nam37/MicroCluck/cad/step/braced-home.step

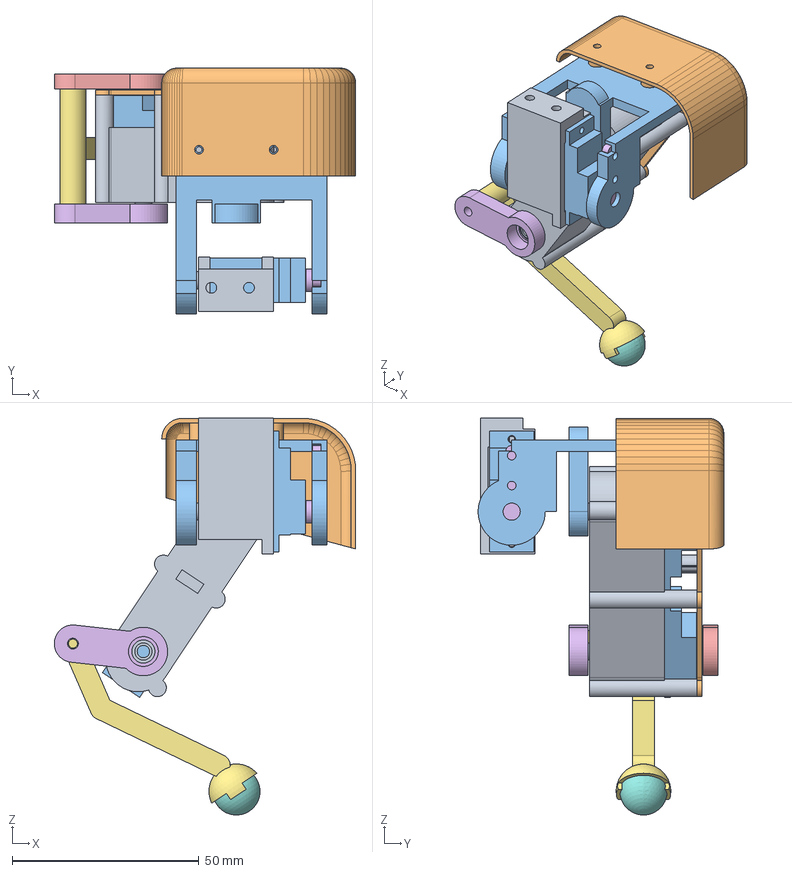
[picture p2: CAD file, 2026-11-11]
cad/step/braced-home.step
80.8 x 65.8 x 106.4 mm
