nam37/MicroCluck/cad/stl/body/body.stl

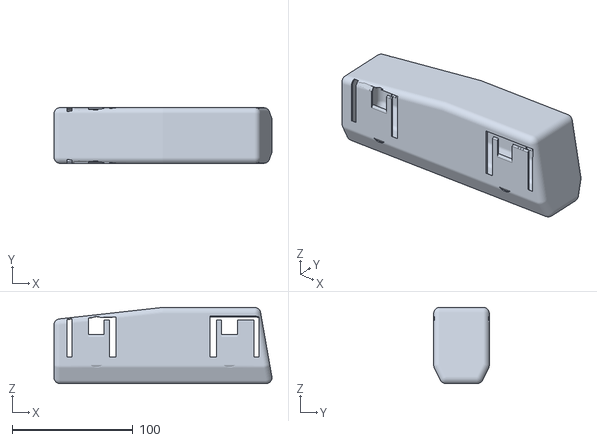
[picture p3: CAD file, 2026-11-11]
cad/stl/body/body.stl
180.2 x 46.0 x 63.0
