nam37/MicroCluck/cad/stl/braced/shank-body.stl

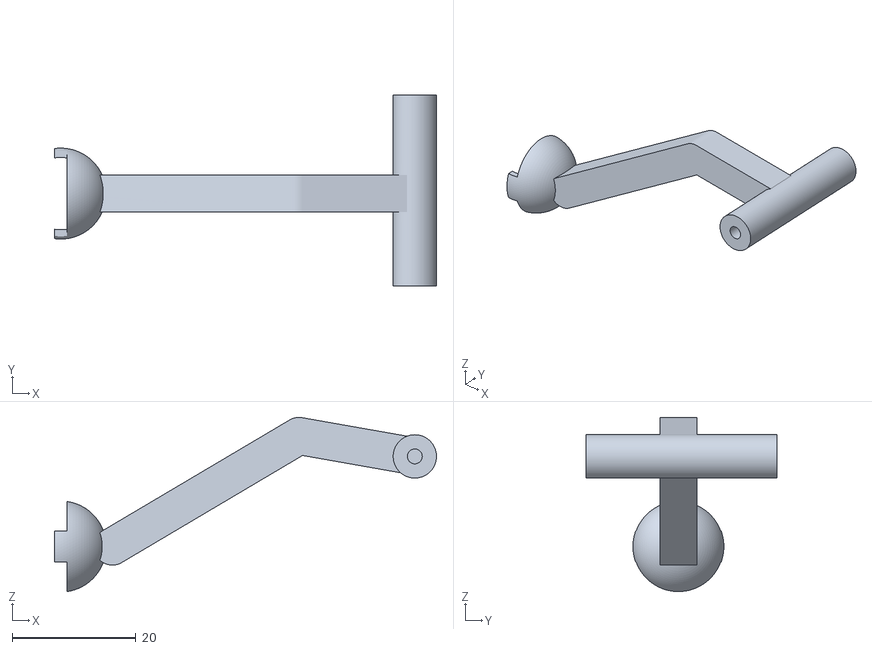
[picture p4: CAD file, 2026-11-11]
cad/stl/braced/shank-body.stl
61.7 x 30.9 x 28.1
