nam37/MicroCluck/cad/stl/leg-fit/fit-horn.stl

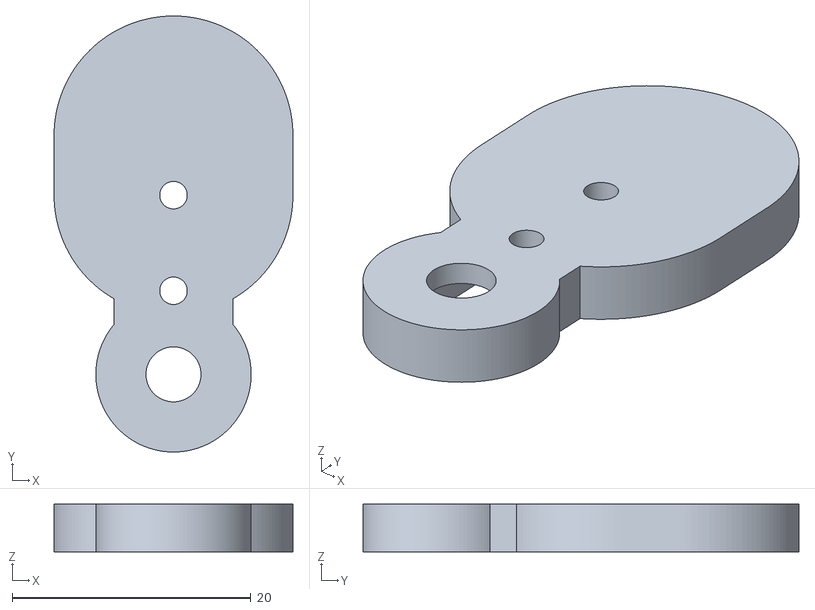
[picture p5: CAD file, 2026-11-11]
cad/stl/leg-fit/fit-horn.stl
20.0 x 36.5 x 4.00
