nam37/MicroCluck/cad/stl/leg/cover.stl

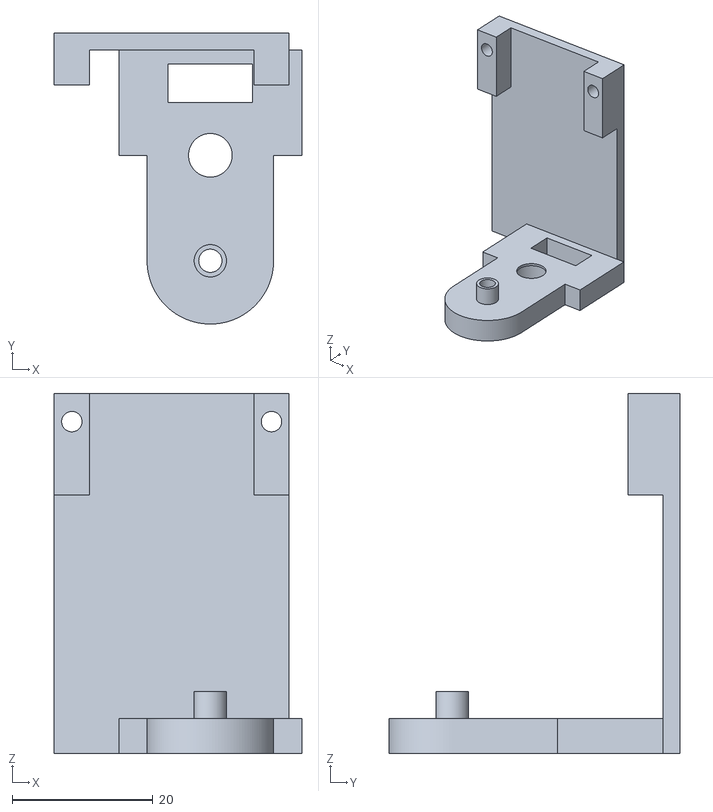
[picture p6: CAD file, 2026-11-11]
cad/stl/leg/cover.stl
35.2 x 41.4 x 51.2
