nam37/MicroCluck/cad/step/body.step

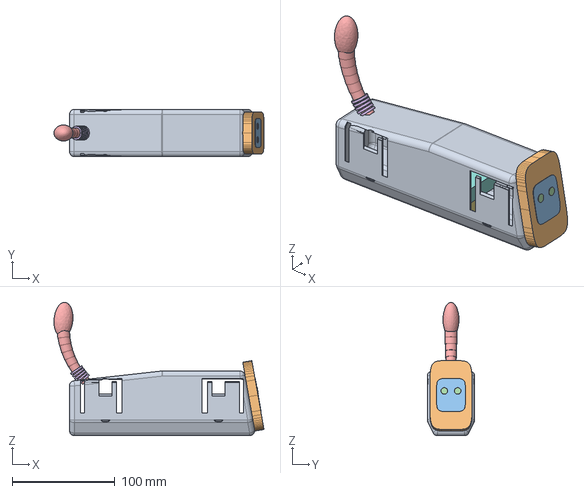
[picture p7: CAD file, 2026-11-11]
cad/step/body.step
204.3 x 46.0 x 129.8 mm
