nam37/MicroCluck/cad/stl/body/screen.stl

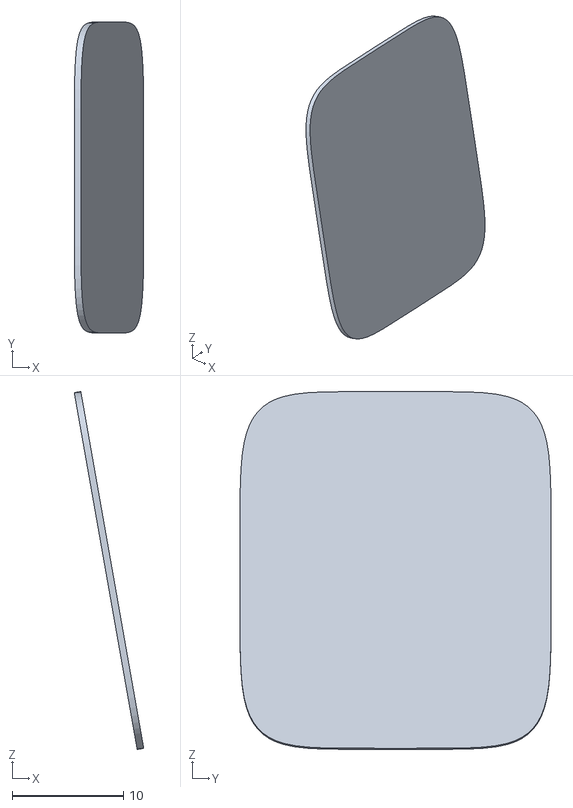
[picture p8: CAD file, 2026-11-11]
cad/stl/body/screen.stl
6.25 x 28.0 x 32.2
