nam37/MicroCluck/cad/stl/braced/bracket.stl

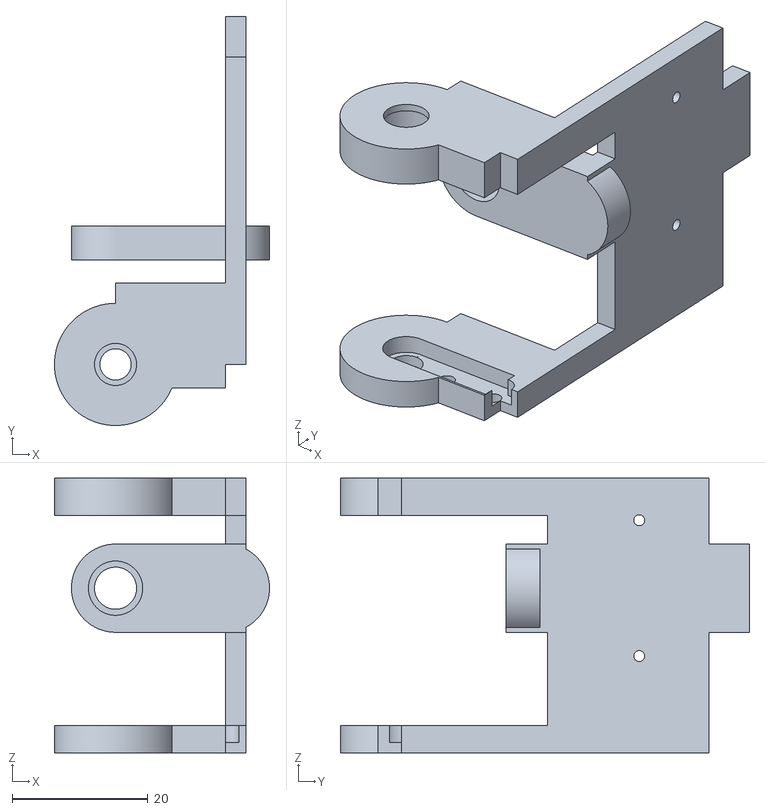
[picture p9: CAD file, 2026-11-11]
cad/stl/braced/bracket.stl
31.7 x 60.2 x 40.5
