nam37/MicroCluck/cad/stl/leg-fit/fit-cradle.stl

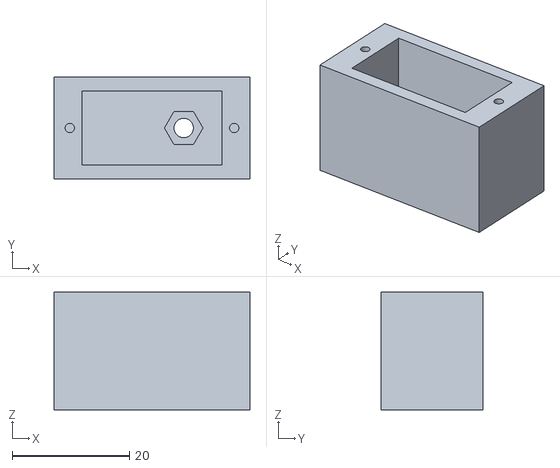
[picture p10: CAD file, 2026-11-11]
cad/stl/leg-fit/fit-cradle.stl
33.4 x 17.4 x 20.1
