nam37/MicroCluck/cad/stl/leg/long-link.stl

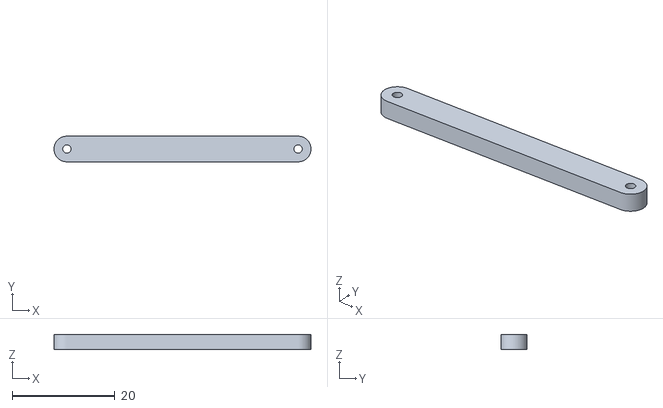
[picture p11: CAD file, 2026-11-11]
cad/stl/leg/long-link.stl
50.0 x 5.00 x 3.00
