nam37/MicroCluck/cad/step/leg-home.step

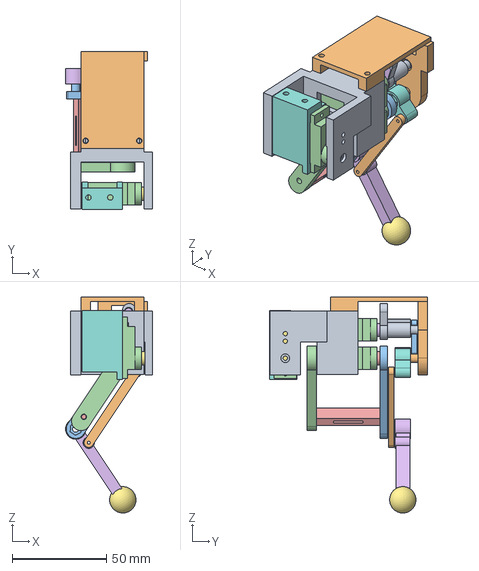
[picture p12: CAD file, 2026-11-11]
cad/step/leg-home.step
46.0 x 83.5 x 114.3 mm
