nam37/MicroCluck/cad/stl/body/eyes.stl

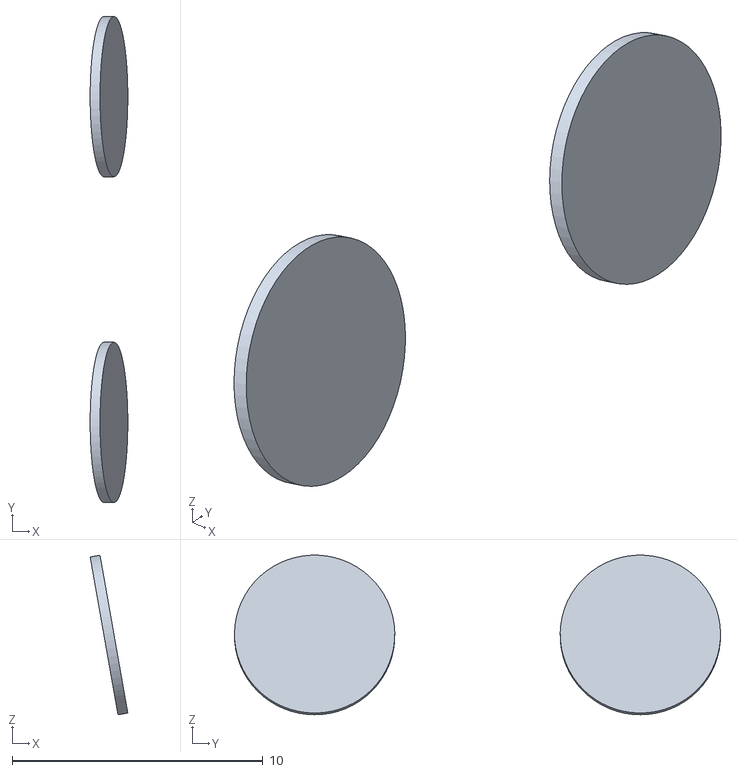
[picture p13: CAD file, 2026-11-11]
cad/stl/body/eyes.stl
1.50 x 19.4 x 6.37
