nam37/MicroCluck/cad/stl/braced/outer-arm.stl

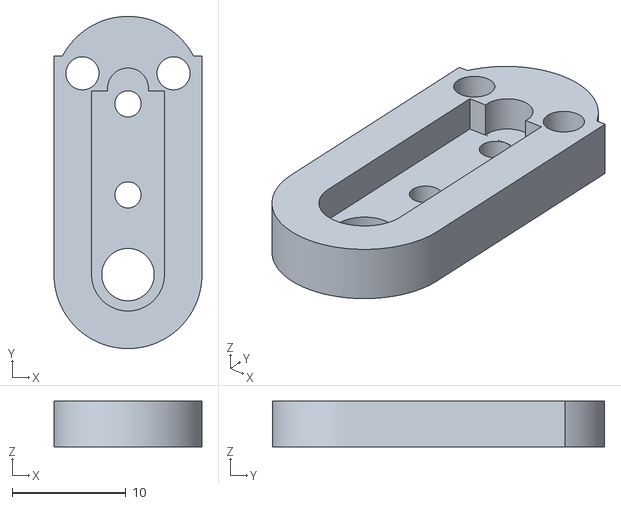
[picture p14: CAD file, 2026-11-11]
cad/stl/braced/outer-arm.stl
13.0 x 29.2 x 4.00
