nam37/MicroCluck/cad/stl/leg-fit/fit-bearings.stl

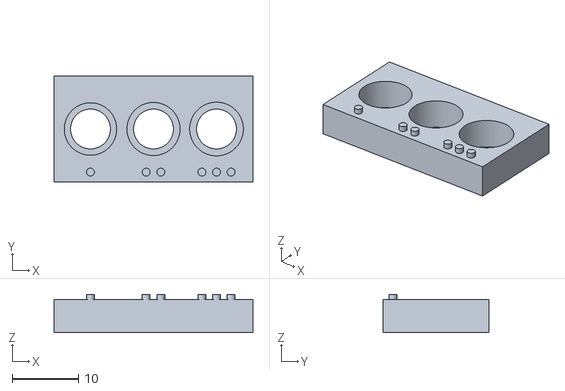
[picture p15: CAD file, 2026-11-11]
cad/stl/leg-fit/fit-bearings.stl
30.0 x 16.0 x 5.80
