nam37/MicroCluck/cad/stl/leg/outer-plate.stl

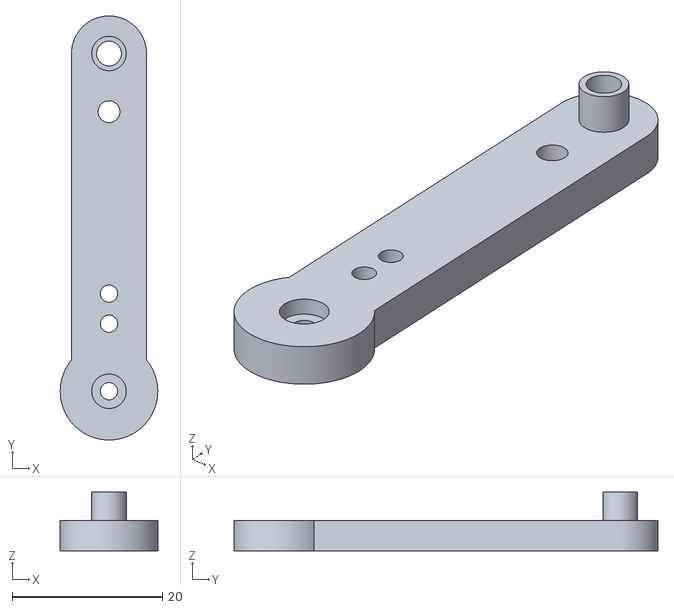
[picture p16: CAD file, 2026-11-11]
cad/stl/leg/outer-plate.stl
13.0 x 56.5 x 7.80
