nam37/MicroCluck/cad/stl/body/bezel.stl

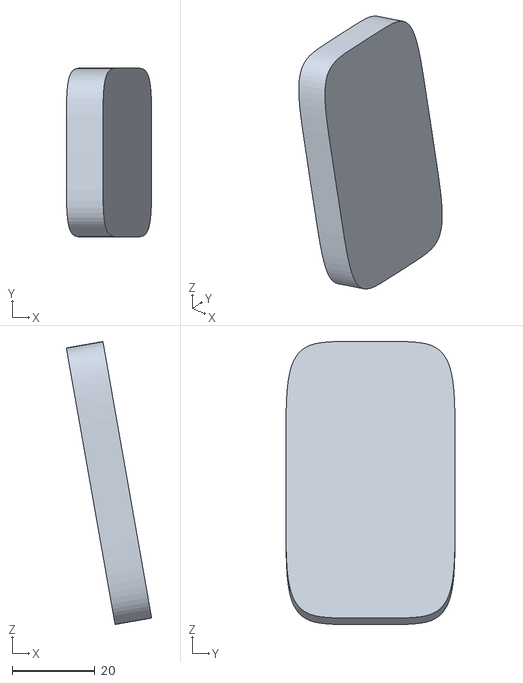
[picture p17: CAD file, 2026-11-11]
cad/stl/body/bezel.stl
20.7 x 41.0 x 68.5
