nam37/MicroCluck/cad/stl/braced/shell.stl

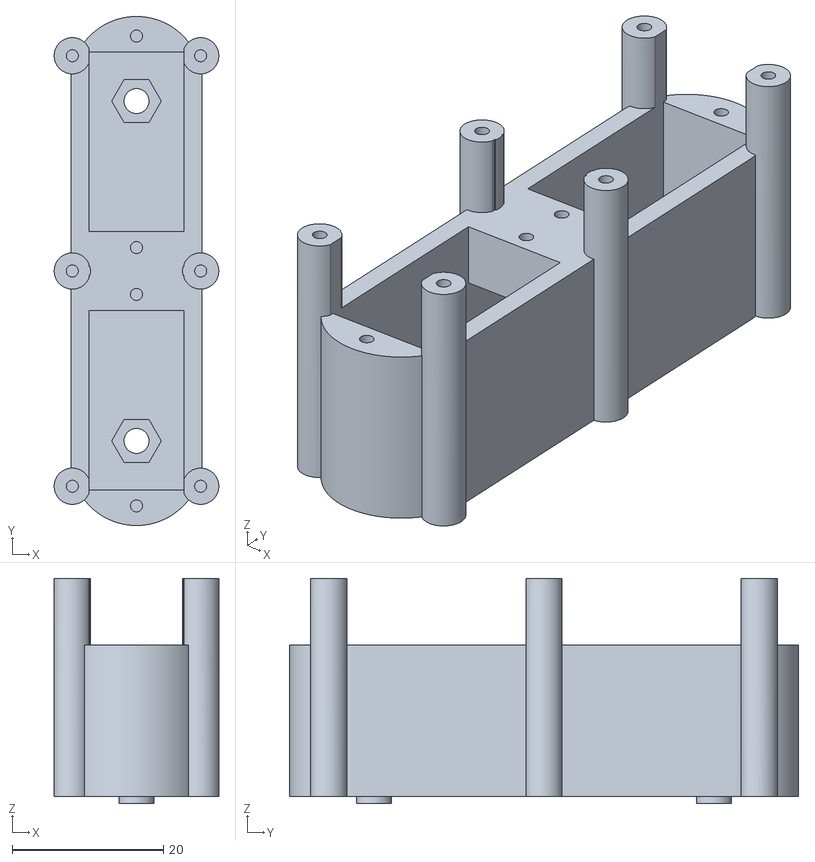
[picture p18: CAD file, 2026-11-11]
cad/stl/braced/shell.stl
21.8 x 67.4 x 29.8
