nam37/MicroCluck/cad/stl/leg-fit/fit-pilots.stl

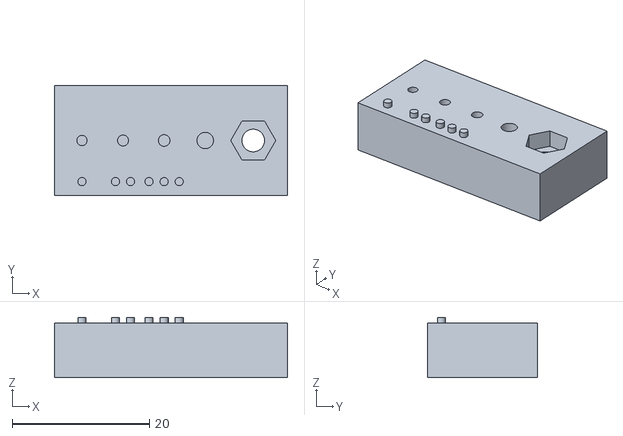
[picture p19: CAD file, 2026-11-11]
cad/stl/leg-fit/fit-pilots.stl
34.0 x 16.0 x 8.80
