nam37/MicroCluck/cad/stl/leg/abd-mount.stl

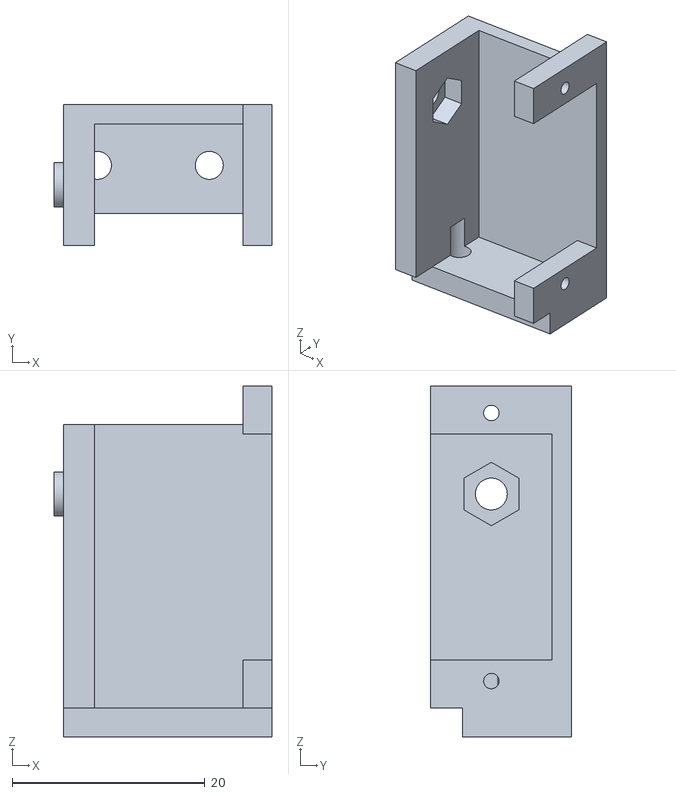
[picture p20: CAD file, 2026-11-11]
cad/stl/leg/abd-mount.stl
22.6 x 14.6 x 36.4
