nam37/MicroCluck/cad/stl/body/tail_boot.stl

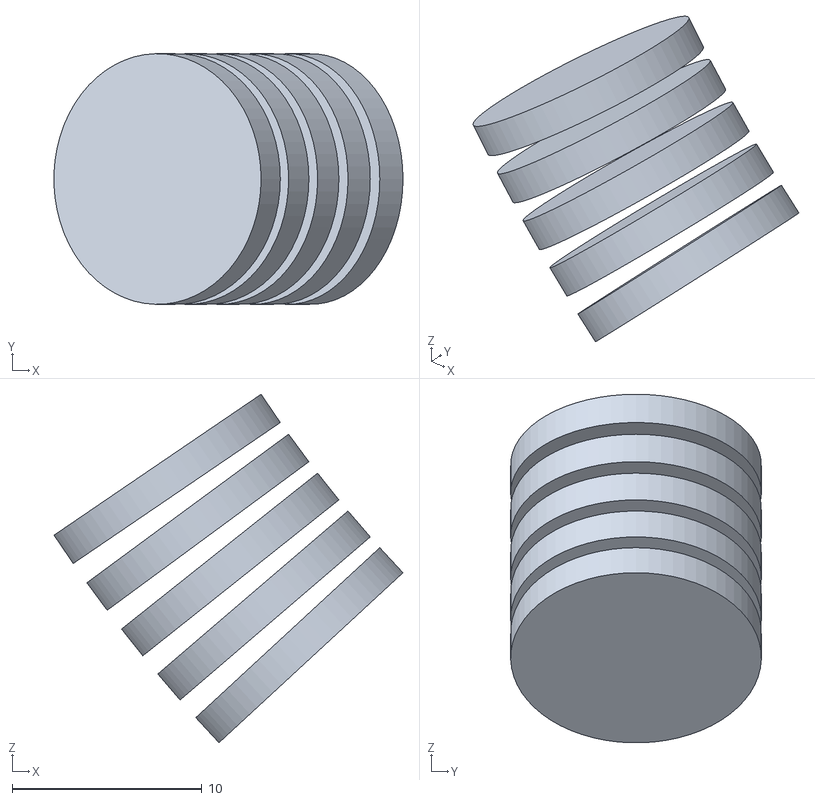
[picture p21: CAD file, 2026-11-11]
cad/stl/body/tail_boot.stl
18.4 x 13.2 x 18.4
