nam37/MicroCluck/cad/stl/braced/rigidity-plate.stl

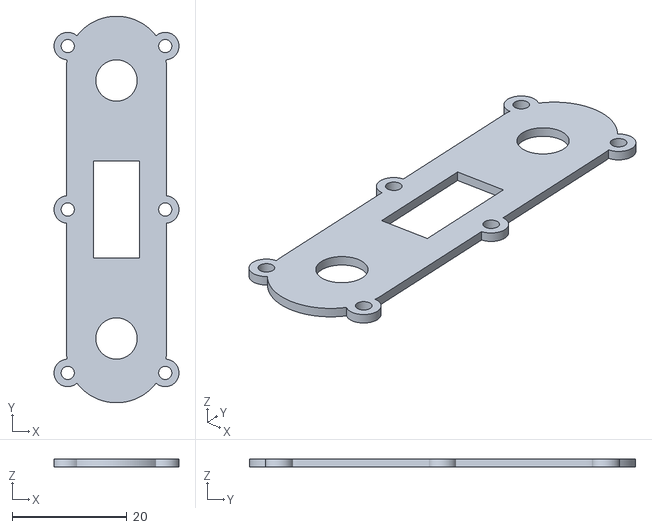
[picture p22: CAD file, 2026-11-11]
cad/stl/braced/rigidity-plate.stl
21.8 x 67.4 x 1.35
