nam37/MicroCluck/cad/stl/leg/knee-crank.stl

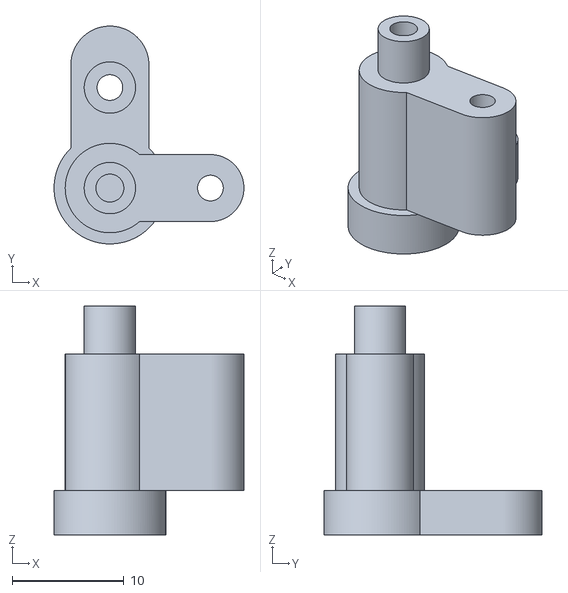
[picture p23: CAD file, 2026-11-11]
cad/stl/leg/knee-crank.stl
17.0 x 19.5 x 20.5
