nam37/MicroCluck/cad/stl/body/tail.stl

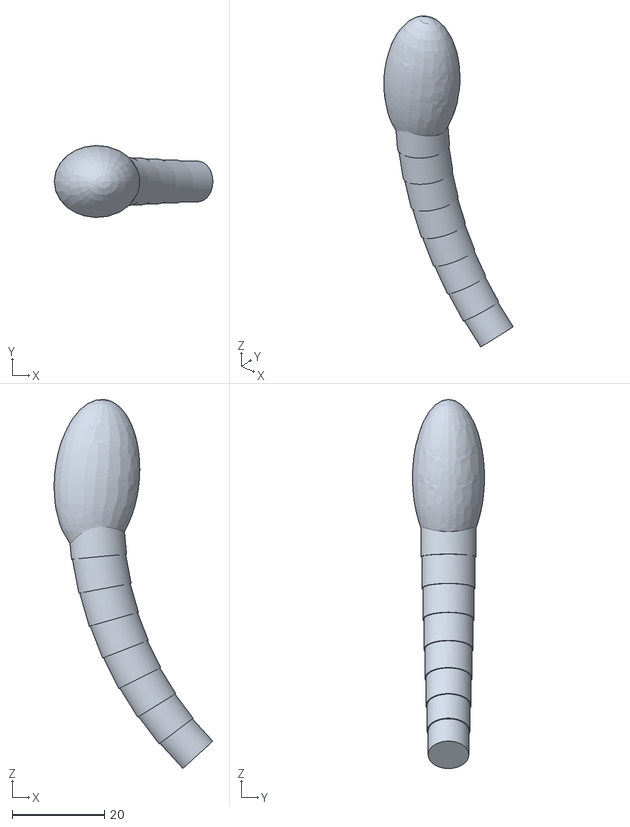
[picture p24: CAD file, 2026-11-11]
cad/stl/body/tail.stl
34.4 x 15.6 x 80.0
