nam37/MicroCluck/cad/stl/braced/shoulder-cover.stl

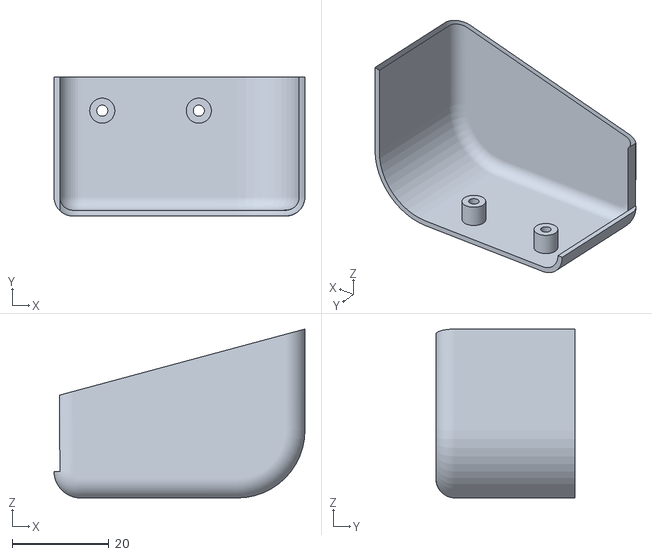
[picture p25: CAD file, 2026-11-11]
cad/stl/braced/shoulder-cover.stl
52.0 x 28.9 x 35.0
