nam37/MicroCluck/cad/stl/leg/inner-plate.stl

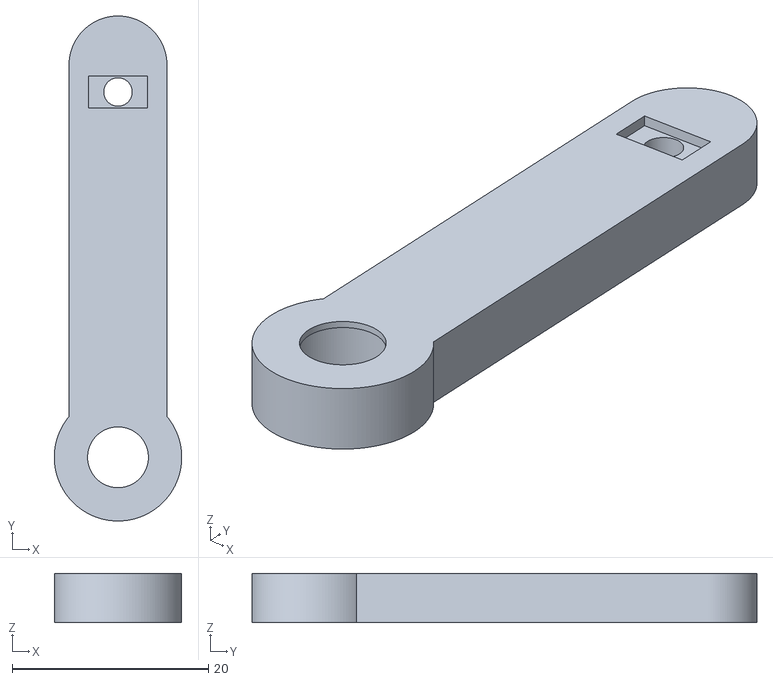
[picture p26: CAD file, 2026-11-11]
cad/stl/leg/inner-plate.stl
13.0 x 51.5 x 5.00
