nam37/MicroCluck/cad/stl/braced/shank-outer.stl

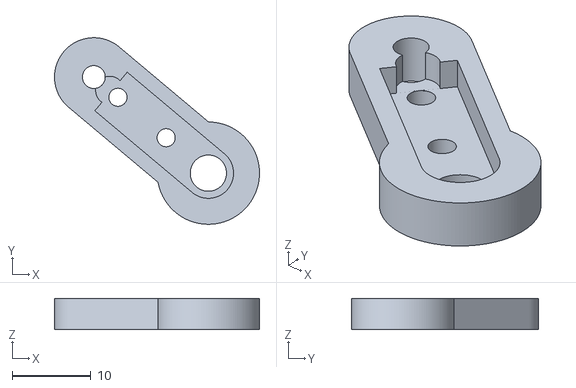
[picture p27: CAD file, 2026-11-11]
cad/stl/braced/shank-outer.stl
26.1 x 23.7 x 4.00
