nam37/MicroCluck/cad/stl/leg/foot.stl

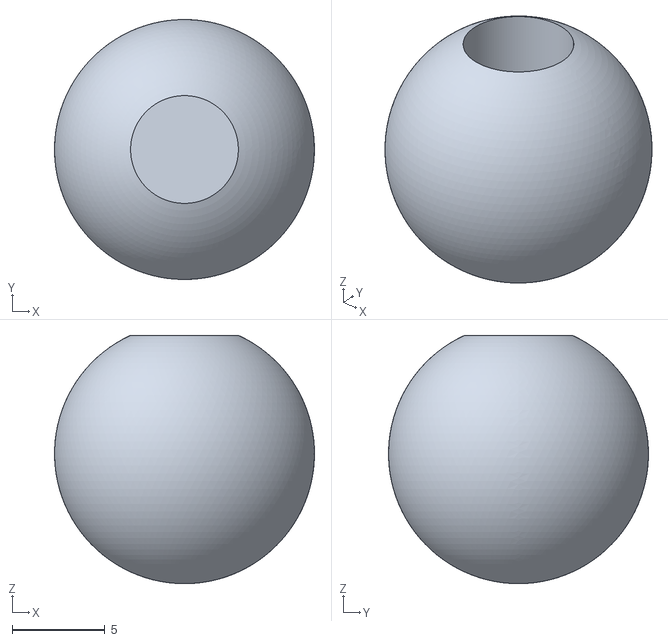
[picture p28: CAD file, 2026-11-11]
cad/stl/leg/foot.stl
14.0 x 14.0 x 13.4
