nam37/MicroCluck/cad/stl/braced/abd-mount.stl

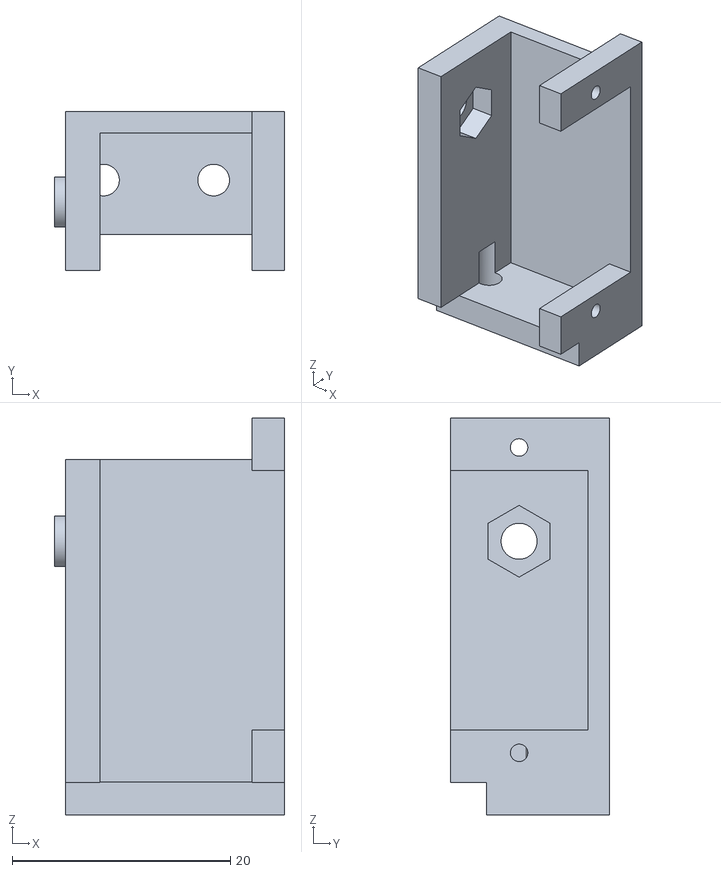
[picture p29: CAD file, 2026-11-11]
cad/stl/braced/abd-mount.stl
21.1 x 14.6 x 36.4
