nam37/MicroCluck/cad/stl/leg/holder.stl

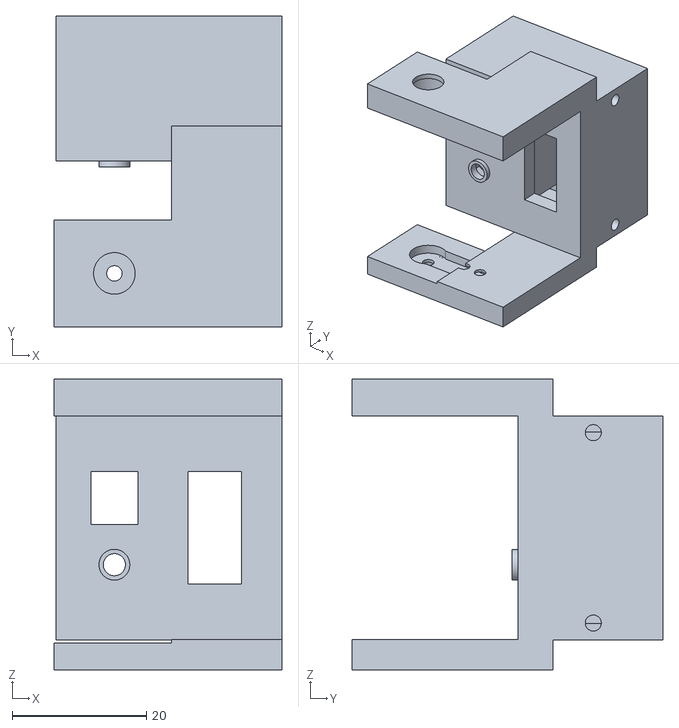
[picture p30: CAD file, 2026-11-11]
cad/stl/leg/holder.stl
34.0 x 46.4 x 43.4
