nam37/MicroCluck/cad/stl/braced/shank-inner.stl

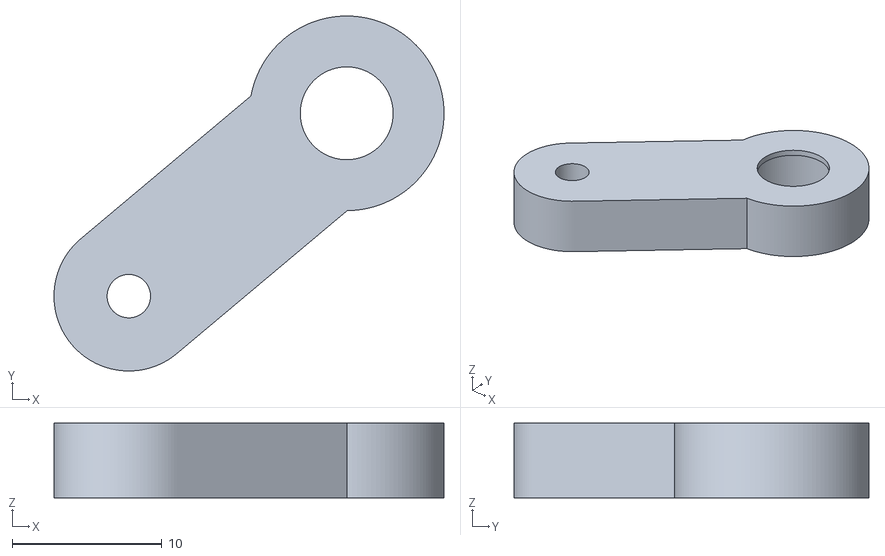
[picture p31: CAD file, 2026-11-11]
cad/stl/braced/shank-inner.stl
26.1 x 23.7 x 5.00
