nam37/MicroCluck/cad/stl/leg/short-link.stl

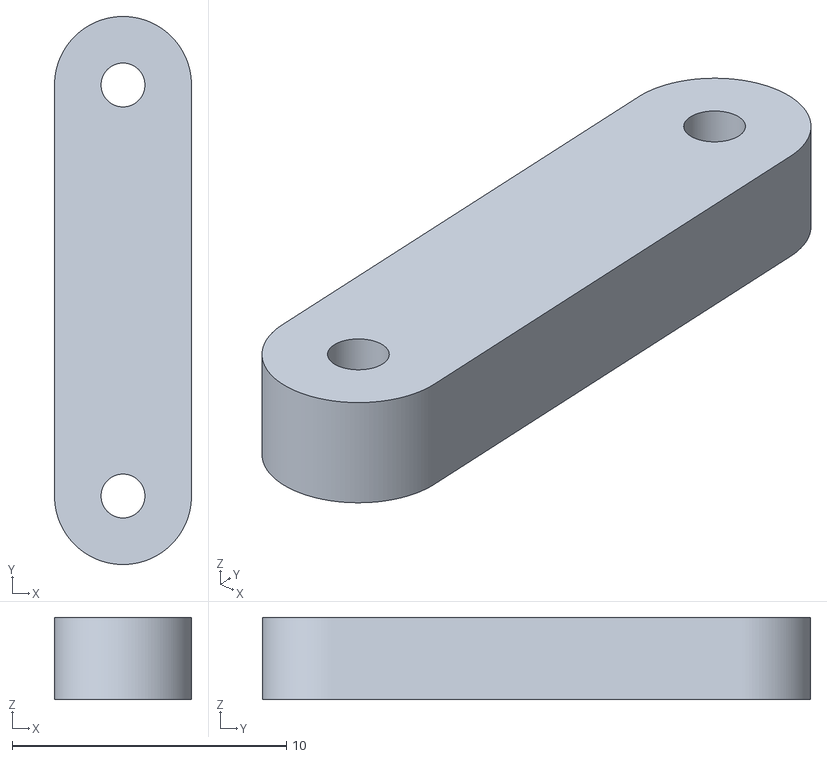
[picture p32: CAD file, 2026-11-11]
cad/stl/leg/short-link.stl
5.00 x 20.0 x 3.00
