nam37/MicroCluck/cad/stl/leg/shank.stl

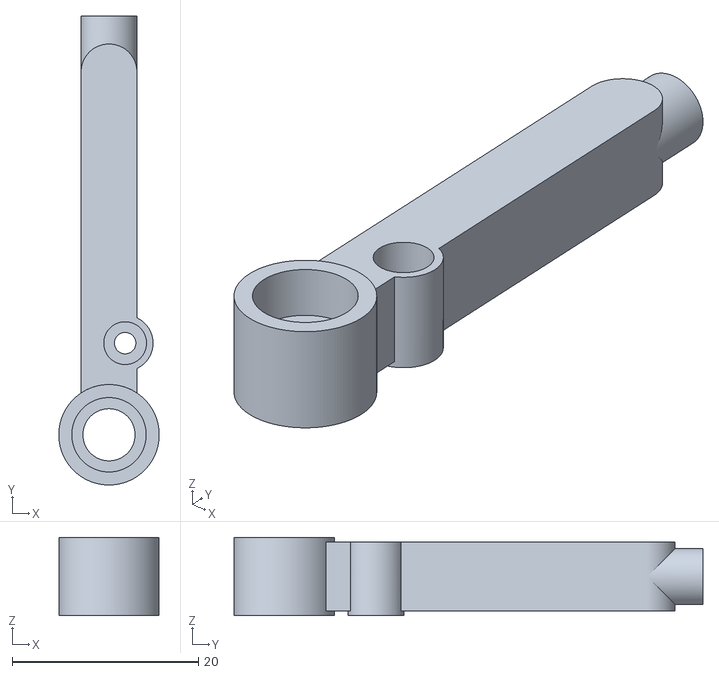
[picture p33: CAD file, 2026-11-11]
cad/stl/leg/shank.stl
10.8 x 50.4 x 8.40
