nam37/MicroCluck/cad/stl/leg/bellcrank.stl

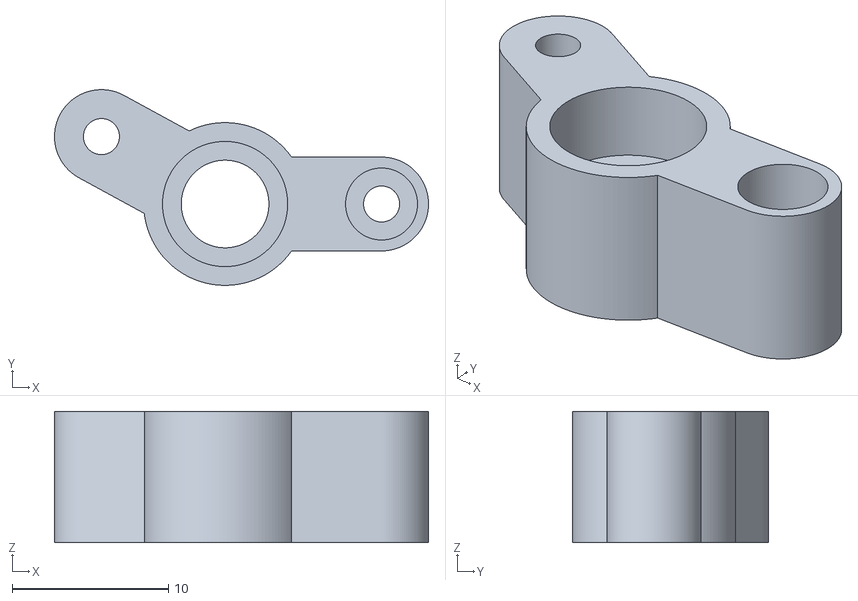
[picture p34: CAD file, 2026-11-11]
cad/stl/leg/bellcrank.stl
23.9 x 12.5 x 8.40
