nam37/MicroCluck/cad/stl/leg/bridge.stl

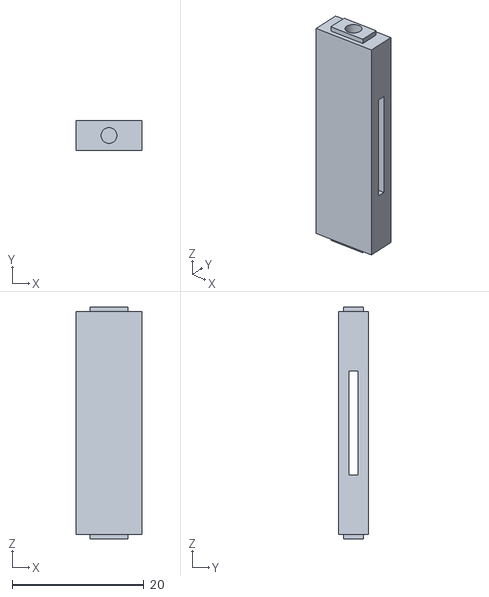
[picture p35: CAD file, 2026-11-11]
cad/stl/leg/bridge.stl
10.0 x 4.50 x 35.2
