nam37/MicroCluck/(commit log)

2026-10-27 Add MicroCluck product requirements document (draft v0.5)
    docs/PRD.html is the current PRD. The superseded v0.3 Markdown draft is
    kept under docs/archive.
2026-10-27 Run servos from the 2S pack and zero-pad command slots (PRD v0.7)
    Servo power follows Microduck and its training model: the pack feeds the
    servos directly (6.6-8.4 V), so the 5 V servo buck is removed. Shutdown is
    set to 52 and health checks ignore the Input Voltage Error bit. The S3
    peak-torque check uses the ~0.60 N.m current-limit ceiling.
    The observation keeps Pollen's 13-slot command block zero-padded (49
    inputs), and the simulation model is edited by hand because Pollen's CAD
    is not published. Adds Pollen's known runtime values to the sim2real
    contract and two watchlist rows (servo supply voltage, no head).
2026-10-27 Add the parametric foot toes in hardware/ and PRD v0.9
    OpenSCAD is the CAD tool for the parametric parts. hardware/ holds one parameter table (params.scad)
    that drives both the printed toes and the simulation: three chunky toes fused onto the front wall of
    Pollen's sole, plus the convex-hull collision shape the sim uses. Pollen's STL files are not copied
    here (CC BY-NC-SA 4.0); the build points at a local copy. Generated STLs are git-ignored.
    PRD v0.8 and v0.9: corrections found while building the first MicroCluck model (tiny command-slot
    ranges, the stock 512-256-128 actor, action scale 1.0 in training and 0.9 on the robot, the head chain
    being 38% of the stock duck's mass), the OpenSCAD d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
    [collision_with_toes.scad, params.scad, pollen_frame.scad, sole_with_toes.scad, toes.scad, toes_lib.scad]
2026-10-27 PRD v0.10: re-base the S3 torque checks on the stock duck's S0 baseline
    The S0 torque baseline (stock walker at iteration 2,000, BAM actuator model, random velocity commands)
    shows Pollen's own duck exceeds the datasheet's ~0.10 N.m continuous rating on hip pitch (0.145 N.m RMS)
    and knee (0.16-0.17) and reaches the 0.64 N.m actuator ceiling on every joint. The S3 thermal and
    peak-torque pass conditions are now relative to the stock duck, with the baseline numbers recorded.
2026-10-28 PRD v0.11: add the parametric body shell in hardware/
    A hollow shell joins the screen bezel's back face to the tail and holds the battery and electronics,
    with a tail socket, a USB-C slot, a power-switch hole and vents. It is a parametric OpenSCAD part:
    torso.scad holds the part layout and shell parameters (geometry only, masses live in the sim) and
    shell.scad builds the body. tools/build_shell.sh exports the STLs and the simulation copies, and
    tools/shell_report.py prints size, wall volume and an estimated mass.
    The simulation draws the battery, electronics and shell (visual-only, physics unchanged) and checks
    that the contents fit and that the legs clear the shell over recorded gait poses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
    [shell.scad, torso.scad]
2026-10-28 PRD v0.12: record the pushes in the S0 baseline and the first MicroCluck results
    The S0 torque baseline and fall counts were measured under the play
    configuration's pushes (every 0.5-1 s), which v0.10 did not say. Add the
    no-push fall result, MicroCluck's torque and fall comparison against the
    stock duck, the walking-speed table (both robots reach about half the
    commanded speed), and the shell clearance with MicroCluck's own gait
    (7.5 mm over all 96,000 poses). Two new watchlist rows cover walking speed
    and the pushed baseline. hardware/README.md gets the clearance result.
2026-10-28 PRD v0.13: egg-shaped shell with wings, and the target look
    Shell (hardware/): torso.scad and shell.scad gain an egg style next to the box. The egg stacks
    convex slices between the bezel cap and a rear wall, with a rounded rear edge (egg_edge_r) and a
    cavity inset that follows the local slope. shell_rear_x sets the depth: the default, -64 mm,
    makes the body 86 mm deep and encloses the placeholder tail block; -30 gives the 52 mm shells.
    Two flat wing discs lie on the sides as a separate part (wings.stl). build_shell.sh also exports
    the cavity and the wings, picks the style, and takes name=value overrides of any torso.scad
    parameter. shell_report.py reports the wings. The README compares the b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
    [shell.scad, torso.scad]
2026-10-28 PRD v0.14: target-look shell, 70 mm deep with the tail behind the rear wall
    Shell (hardware/): the default egg is now the target-look shape: 70 mm deep (shell_rear_x = -48),
    top sloping about 20 degrees from the bezel, rounded rear edge, and an underside that rises 18 mm
    toward the rear (egg_power_floor, shell_rear_z0 = 42). The tail placeholder moves behind the rear
    wall (tail_pos x = -63), and the rear wall gets an opening for the tail's mounting stub
    (tail_stub_size, tail_stub_z) instead of one sized from the tail block. The USB slot is a column
    through the rising floor. The cavity wall pad now grows from the front to the rear
    (egg_wall_pad, egg_wall_pad_rear) so the front walls stay ligh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
    [shell.scad, torso.scad]
2026-10-30 PRD v0.15: getting up from the screen, and where the hips go
    New section 7.5 with the stand-up and walking results from simulation:
    - the stock leg layout cannot get up from lying face down (0 of 64);
    - with the leg mounts raised 55 mm or more it can (60 to 64 of 64), tested
    with the legs 25 mm outside the shell;
    - walking with the hips raised 70 mm stands still from a cold start but
    walks when warm-started from the stock policy, with weaker push recovery;
    - what is not shown yet: one layout that gets up, walks and fits the screen,
    battery and electronics.
    Also a risk row, a watchlist row, an open question on the hip position, and a
    note on the H7 milestone.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
2026-10-30 PRD v0.15: say that the stand-up runs let only the soles and torso collide
    The simulator switches off every geom not named *_collision, so the thighs, shanks and hip brackets
    passed through the floor and body in the stand-up searches. The stock layout's failure stands; the
    successes are upper bounds and are being re-run with all leg parts colliding.
2026-10-30 PRD v0.16: stand-up re-run with every leg part colliding
    The simulator collides only geoms named for collision, so in v0.15's searches the thighs, shanks and
    hip brackets passed through the floor and the body. With every leg part colliding, legs 25 mm outside
    the shell and the stock hip position both fail (0 of 64); hips raised 70 mm, at the stock spacing and
    moved 29 mm back, get up in 62 of 64 starts. Walking at that hip position is untested and the hips sit
    inside the shell's outline, so the shell needs openings. Table, packaging, watchlist and open question
    updated.
2026-10-30 PRD v0.17: walking with the hips moved back, and getting up from the back and side
    The hips raised 70 mm and moved 29 mm back (the one layout that gets up face-down with every leg part
    colliding) also walks: the home pose leans 43° at the hip pitch, and the stock policy trained 500 more
    iterations reaches 0.17 and 0.24 m/s at 0.3 and 0.4 m/s commands (stock hips 0.19 and 0.27), with 30
    falls against 27 under pushes. Lying flat on the back neither layout gets up (0 of 64); from starts
    rolled toward the side the hips-back layout gets up in 6 of 64. Packaging, gait clearance and a
    sit-up-then-stand recovery are still open.
2026-10-30 PRD v0.18: corrected raised-hip results, feather-fan tail, mean-motion replays
    Pollen's chassis plate and its 50 g were left at the old low position in every raised-hip test since
    v0.15, putting the whole-body center of mass 9 mm too low; v0.17's hips-back numbers are superseded.
    With the chassis moved, the tail estimated from the design mockups as a rigid feather fan, and every leg
    part colliding: hips raised 70 mm and 29 mm back get up face-down in 255 of 256 starts (61 to 84% with
    the earlier tail block), walk at 91-93% of the stock layout's speed (home pose leaning 41 degrees, 31
    falls under pushes against 19), get up from flat on the back in 3% and from the side in none; the stock
    hips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
2026-10-30 PRD v0.19: getting up from the back and side by rolling onto the front first
    The back and side searches of v0.17/v0.18 kept the legs mirrored, which cannot roll the body, so
    their 3% and 0% described mirrored motions only; the text now says so. With all ten joints free,
    rolling onto the front works (256/256 from flat on the back and from a side, mean motions), and a
    stand-up searched behind it gets up 255/256 from up to 30 deg from flat on the back and 254/256
    from a side. Around 45 deg neither roll is reliable. A recovery policy trained from scratch on
    lying starts learned nothing (0/256, action noise 1.0 -> 0.12). All open-loop, in simulation.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
2026-10-31 PRD v0.20: how far the open-loop get-up holds under changed physics
    The two chained recoveries (from a side, and from up to 30 degrees off flat on the back) replayed on 256 starts
    with friction, battery voltage, servo delay, extra trunk mass and the trunk centre of mass changed. Single changes
    cost little; extra mass with a low battery drops them to 42% and 24%; the centre of mass 10 mm back or down, or 20 mm
    anywhere, takes them to about 0%. Taking away all leg-body contact drops them to 49% and 77%. The roll onto the
    front survives the combined worst case; the stand-up behind it is what breaks. An earlier version of this test did
    nothing for the centre of mass and is corrected. hardware/RE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
2026-10-31 PRD v0.21: the get-up works inside a narrow window of the fore-aft balance point; robust re-search
    Corrects v0.20: the collapse under extra mass plus a low battery is a shift of the balance point, not a torque limit. The same
    combination with the trunk centre of mass 8 mm back gets 95-100% for all four motions and 8 mm forward gets 0%. Each motion gets up
    in 84% or more of starts only between about 4 mm back and 8 mm forward of the model's centre of mass. Searching the motions again
    over randomized physics worked only as a warm start from the existing stand-ups (from scratch the stand-up never reached
    standing); the re-searched motions are better under low friction, low battery and mass plus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
2026-10-31 hardware: bezel with top and bottom bumper lips (bezel.scad), lip parameters in torso.scad
    The frame's top and bottom edges become rounded bars standing bezel_lip_proud ahead of the frame face (6 mm placeholder; 0 is the flat
    frame). The sim collides with capsules built from the same numbers; with up to 8 mm its open-loop get-up works, at 12 mm the side get-up falls to 70%.
    [bezel.scad, torso.scad]
2026-10-31 PRD v0.22: a learned correction on the get-up motions widens the balance-point window from 12 to 32+ mm; bezel bumper lips in the model
    The policy corrects the open-loop roll and stand-up: 98-100% of starts from 12 mm back to 20 mm forward of the model's centre of mass (open loop:
    4 mm back to 8 mm forward), 100% under extra mass with a low battery and under a combined worst case. Weak point: servo delay beyond the 50 ms it
    was trained on. Bezel lips up to 8 mm leave the open-loop get-up unchanged, 12 mm drops the side get-up to 71%; the policy trained with 6 mm lips
    loses backward margin on a flat bezel. Simulation only.
2026-11-09 PRD v0.23: robot-dog simulation study (docs/quadruped-study.html)
    Walking, servo load against the stock duck, belly get-up, and the rejected
    knee-at-hip and lean-mass variants, from runs 4-7 of the 8-servo quadruped.
2026-11-09 BOM: XL330-M288-T price and source, U2D2 added (PRD 6.1 and the dog study)
2026-11-10 PRD v0.24: MicroPup replaces the MicroCluck biped
    Rewritten around the dog: DeskSprite face on the FNK0104N, an 8-servo
    XL330 body with an XL330 tail, and three boards (face, body ESP32-S3 with
    all safety, XIAO ESP32S3 Sense vision). Camera moves to the forehead,
    tilted up with a wide lens; ToF stays in the chin with an obstacle stop
    (S11). Face-body UART link, lie-down/stand-up state machine, v2 autonomy
    with vision off the robot, BOM ~$505-565. The biped PRD is archived
    unchanged at docs/archive/PRD-MicroCluck-v0.23.html.
2026-11-10 PRD: the relay's 1 CPU / 256 MiB are its container limits, not the VPS's size; v2 vision gets its own container
2026-11-10 PRD: home Raspberry Pi 4 as a possible future vision server, reached over Tailscale via the VPS away from home
2026-11-10 PRD v0.25: ESP32-P4 (FireBeetle 2) is the default vision board; person detection on the robot
2026-11-10 PRD v0.26: Waveshare ESP32-P4-WIFI6 Kit A for camera bring-up (V0); robot's P4 board chosen after V0
2026-11-10 PRD v0.27: ESP32-S3 N16R8 2-pack as body-board bench boards; XIAO stays the robot default
2026-11-10 PRD v0.28: SG90-class micro servo for the tail, XL330 order 8 + 1 spare (~$247)
2026-11-10 PRD BOM: U2D2 Power Hub Board for bench servo setup
2026-11-10 PRD v0.29: the four pre-freeze simulation checks pass on the final model
    Forehead camera, chin ToF and ears in the model (596 g); run 8 trained with
    +-1 deg gear play walks 0.26 m/s at 0.3, turns 0.70 rad/s, no falls, worst
    joint 0.123 N.m; leg clearance >= 6 mm to the shell and 19 mm to the bezel
    over 96,000 gait poses; scripted lie-down 64/64 under every stress. Study
    page gains a run 8 section.
2026-11-10 Docs: servo cost study (STS3215 and MG90S rejected), PRD v0.30 build-or-buy question
2026-11-10 PRD v0.31: MicroPup redesigned for cost (MG90S, one ESP32-P4 board, 1.69in face); XL330 PRD archived as v0.30
2026-11-10 PRD v0.33: scripted trot walks the MG90S micro dog in sim (0.16 m/s, steers, no falls under pushes); MG92B under test
2026-11-10 PRD: BOM and servo drive for the scripted gait, no potentiometer read-back; MG92B noted as an option
2026-11-11 PRD v0.34: MG92B walks on a learned policy with pot read-back; 3 servos per leg gives no gain; servo choice reopened
2026-11-11 CAD: Orion-style 12-servo MG92B leg in build123d, with fit coupons and a range-of-motion checker
    Holder for the stacked hip and knee servos hung from the abduction servo (horn in front, 693 bearing behind), two-plate thigh with a bearing behind the hip servo, bellcrank and two parallelogram links to the knee, shoulder cover carrying the bellcrank axle and the knee crank's outer bearing. check_fit.py finds no collisions over knee 30-140, hip -35..+70 and abduction +-29 for front and rear legs.
    [abd-mount.stl, bellcrank.stl, bridge.stl, cover.stl, fit-bearings.stl, fit-cradle.stl, fit-horn.stl, fit-pilots.stl]
2026-11-11 CAD: whole-robot animation of the Orion-style legs (MuJoCo, kinematic): stand, trot, paw, crouch
2026-11-11 CAD: MicroDuck-braced 12-servo leg (hip and knee servos in the thigh, U hip bracket, fork shank); 46.5 mm wide vs 69, no collisions over knee 0-150, hip -70..+80, abduction +-29
    [abd-mount.stl, braced-home.step, bracket.stl, foot.stl, outer-arm.stl, rigidity-plate.stl, shank-body.stl, shank-inner.stl]
2026-11-11 CAD animate.py: --replay draws a trained policy's walk from the simulation with the CAD parts
2026-11-11 CAD braced leg: heel fork (plates and rod behind the knee, bar to the foot) so the leg tapers; foot-first lean 41->63 deg straight, 36->58 standing, 27->43 crouched; foot_first.py; 27/27 poses clear 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
    [braced-home.step, shank-body.stl, shank-inner.stl, shank-outer.stl]
2026-11-11 CAD braced leg: shoulder cover on the bracket (wraps the top and the front of the hip, short rear lip, outer side panel; same part on all four legs), abduction plates trimmed to lobes so left and rig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
    [braced-home.step, bracket.stl, shoulder-cover.stl]
2026-11-11 CAD body.py: the simulation-style body (sloped top, face leaning back 10 deg, paddle tail) built around the braced legs: front +6 mm for the abduction plates, rear slope 10 mm (rear abduction mounts)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
    [bezel.stl, body.step, body.stl, eyes.stl, screen.stl, tail.stl, tail_boot.stl]
2026-11-11 CAD: rounded shoulder cover (hollowed solid, 14 mm front curve, 4 mm rounded outer edge, fender-like side); body openings cut with the cover's envelope, with a guard against bad booleans; 27/27 poses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
2026-11-11 CAD: narrower shoulder cover (inner edge 4 mm outside the case bottoms) so it clears the body at full outward abduction; only the bracket's inner arm still needs a notch
    [body.step, body.stl]
2026-11-11 CAD body: 1.2 mm walls (54 g, was 71), front leans back 10 deg like the face so the bezel sits flush instead of cutting into the shell; fit check unchanged (11 known swung-back limits only)
    [bezel.stl, body.step, body.stl, eyes.stl, screen.stl]
2026-11-11 CAD layout study: 8 servos as the body's corners (after Mini Pupper 4), Orion holders fixed to the body; 129.6 mm across with the Orion parts as they are, 119.8 with the thigh held on the outside onl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
    [layout_corner8.py]
2026-11-11 PRD v0.35: 12 MG92B on the braced leg with pot read-back, sim-style body and shoulder covers (cad/), learned walk under the servo contract with the hip-and-knee walk first (b5/b6 queued), 12-servo ru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
2026-11-11 PRD v0.35: staged purchase plan (servo source chosen by a bench test, abduction servos last) and a v0 bench BOM for branded vs clone MG92B; H0 measures both batches
2026-11-11 PRD v0 bench BOM: real listings (Adafruit 2307 genuine MG92B, AliExpress 4-pack), no destructive servo test
2026-11-11 PRD: no AliExpress clones; Amazon and Adafruit as the default sources (Where column in both BOMs), 14 genuine MG92B from Adafruit, three ADS1115 for the pots, BOM ~$330-385
2026-11-11 PRD v0.36: leg servos switch to MangDang's TTL serial bus servo (Mini Pupper 2's): position read back over the bus, no soldering; bus adapter and servo power switch replace the PCA9685 and pot ADCs; 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
2026-11-11 PRD: b3/b4 results (b3 walks upright at 86 mm, 0.1-0.34 m/s, turns, 0 falls; history did not help); b5/b6 training
2026-11-11 CAD: leg refitted to MangDang's bus servo (SCS0009 case, sizes from MangDang's Mini Pupper STEP and servo drawing); MICROPUP_SERVO=mg92b keeps the old stand-in. Horn 2.3 mm lower: leg 2.9 mm narrower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
    [abd-mount.stl, body.step, body.stl, braced-home.step, bracket.stl, fit-cradle.stl, fit-horn.stl, outer-arm.stl]
2026-11-11 CAD render.py: --braced renders the braced leg
2026-11-11 CAD foot: a bought 1/2" Buna-N 70A rubber ball (USASEALING 5-pack on Amazon, McMaster 1854T54) snapped into a side-cheek cup on the shank (1 mm past the middle at the sides, open front and back so cr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
    [braced-home.step, foot.stl, shank-body.stl]
2026-11-11 PRD: rubber-ball feet in the BOM and §6.5; leg width and shoulders for the bus servo
2026-11-11 PRD v0 bench BOM: Amazon/Adafruit listings; Waveshare 6 V bus-servo buck adapter and a 12 V wall adapter (the bus adapter needs 9-12.6 V); robot servo power added as an open question
2026-11-11 PRD v0 bench BOM: STEMMA QT cable with female sockets (Adafruit 4397) for the board's pin headers
2026-11-12 PRD §7.2: b7 (b6 settings on the leg refitted to the bus servo, rubber-ball foot) training
2026-11-12 PRD: IMU is the DFRobot Gravity BMI323 (Amazon), bought with the bench kit; Qwiic cable kit in the bench BOM; IMU read on a timer (no soldered interrupt), address 0x68
2026-11-12 PRD v0 bench BOM: the Amazon order as placed on 11 Nov 2026 ($125.97): Waveshare Serial Bus Servo Driver Board instead of Adapter (A), BMI323, 10-pair screwless barrel connectors, ANMBEST MOSFETs, Qw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
2026-11-12 PRD bench BOM: the ordered board (B0CTMM4LWK) is Waveshare's Bus Servo Adapter (A), no ESP32; IDs set with Feetech's PC tool over USB
2026-11-12 PRD §7.2: b7 results (braced3 leg on the bus servo, ball foot): close to b6, 0 falls unpushed, worst joint 58% of stall; slowest walk and slow turn weaker
2026-11-12 PRD bench BOM: the Amazon bench kit is planned, not ordered (the 11 Nov order was never finalized)
2026-11-12 PRD: the MangDang servo order (14 servos) is not placed yet either
